jeagan626/J-Box/Jbox M3.jpeg

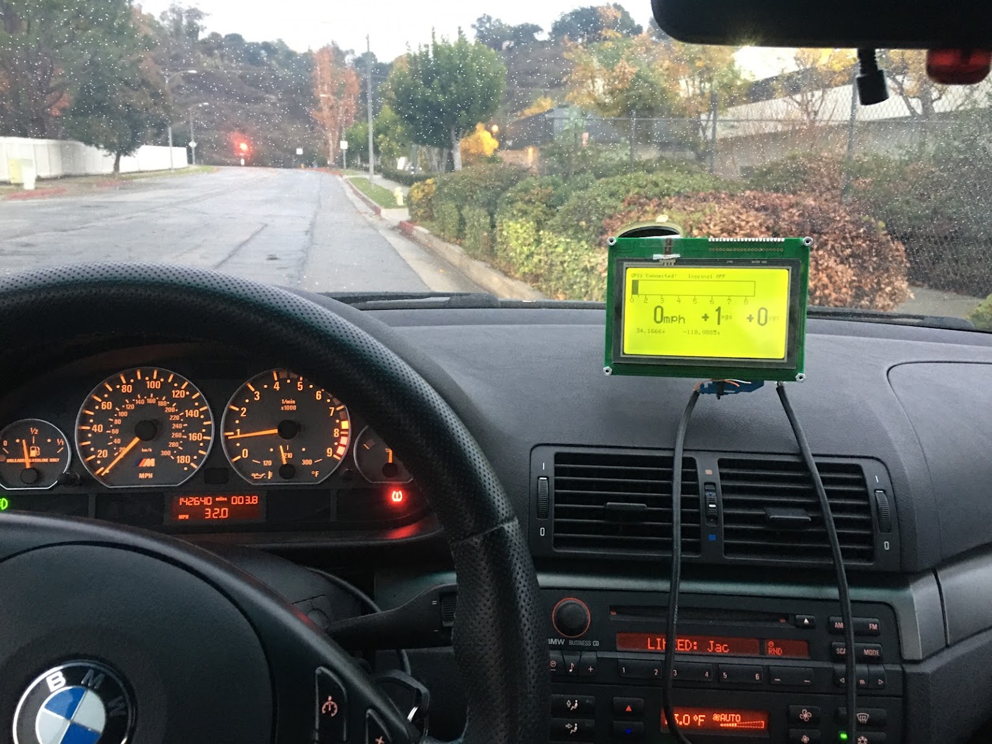
Jbox M3.jpeg
