jeagan626/J-Box/Imported Performance Logger.PrjPcb/BiggDisplay.STEP

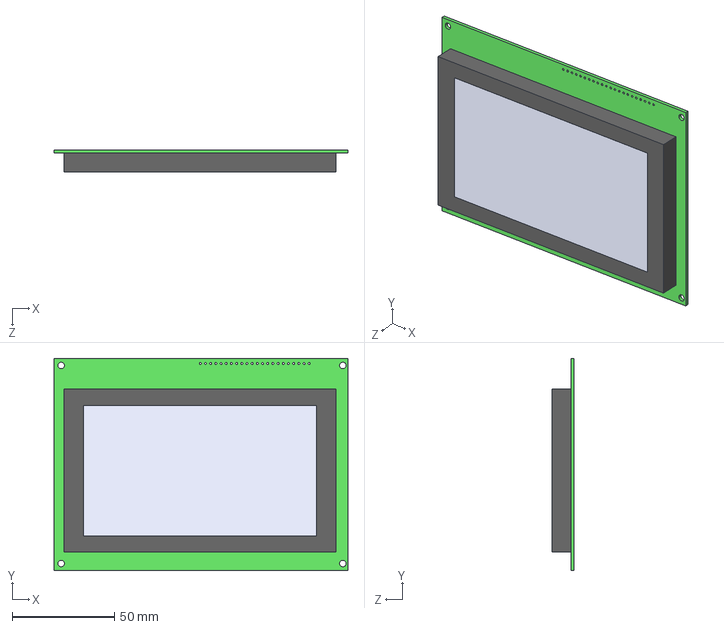
[picture p2: CAD file, 2021-08-30]
Imported Performance Logger.PrjPcb/BiggDisplay.STEP
144.0 x 104.0 x 11.0 mm
