jeagan626/J-Box/(list of files, cad)

Other CAD files:
Imported Performance Logger.PrjPcb/BiggDisplay.SLDPRT
