jeagan626/J-Box/(list of files, drawings)

Other design files:
Imported Performance Logger.PrjPcb/New folder/Performance Logger1.PcbLib
Imported Performance Logger.PrjPcb/New folder/Performance Logger.PcbDoc
Imported Performance Logger.PrjPcb/New folder/Performance Logger.PrjPcb
Imported Performance Logger.PrjPcb/New folder/Performance Logger.SchDoc
