jeagan626/J-Box/(commit log)

2021-08-15 Broke Up into multiple files
    [gps.cpp, main.cpp]
2021-08-30 Added Electronics Documents
    [BiggDisplay.SLDPRT, BiggDisplay.STEP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]
2021-12-15 added digital gauge class
    Started IO integration, added class for printing digital values to the screen
2021-12-20 Performance Improvements
    To do: write function that correctly rotates the update coordinates
    [display.cpp]
2021-12-23 minor improvements
    cut 5ms off display time by eliminating redundant updates
2021-12-24 Switched to interrupt based timing for RPM counting
2021-12-25 minor performance improvement and patches
    Staged display requests to avoid writing to the display unless new information is present. Fixed digital gauge issues with integers.
    [display.cpp, main.cpp]
2021-12-26 Started Logging integration
    Added basic functions to support logging. Ability to easily display dates with the LCD. SD initialization function. Also method to sync Teensy RTC with GPS clock for better time stability.
    Firmware info:
    RAM: [= ] 5.2% (used 13548 bytes from 262136 bytes)
    Flash: [== ] 22.6% (used 118472 bytes from 524288 bytes)
    [display.cpp, display.h, gps.cpp, gps.h, logging.cpp, main.cpp]
2021-12-26 Minor improvement
    Switched to constant for storage of icon bits. Removed extra junk from sd initialization process
    RAM: [ ] 4.7% (used 12252 bytes from 262136 bytes)
    Flash: [== ] 22.6% (used 118376 bytes from 524288 bytes)
2021-12-28 Major Update
    -added button and touch event classes for creation of GUI
    -added to logging (successfully creates a CSV file)
    - added to time stamping functions
    -added global data (to pass variables between files)
2021-12-28 Basic Logging
    Log button now starts a new log and stops a log. Pretty simple- button and touch handling could use some improvement, as some spots are "bouncy"
2021-12-28 fixed display glitch
    tachometer needs to be written before status. perhaps tach overwrites too much data
    [display.cpp]
2021-12-28 Minor bug fix
    The allocated length of dateTimeString was too small causing the date display on the screen to freeze.
    [logging.cpp]
2021-12-28 logging addendum
    added more digits to in lat and lon in logs,
    Added ability to start logging to SD
    inserted while running without a restart
    BUGS:
    The file directory is messy
    [display.cpp, logging.cpp]
2021-12-28 Logging Update
    Major improvements in logging reliability.
    - Has enum to track any sd /logging related errors.
    -displays any errors related to logging
    -is able to successfully initialize a log with the sd hotswapped
    -automatically places logs in a dated directory and names them according to the time
    RAM: [ ] 4.8% (used 12460 bytes from 262136 bytes)
    Flash: [== ] 23.5% (used 123168 bytes from 524288 bytes)
    [display.cpp, globalData.cpp, globalData.h, logging.cpp]
2022-01-02 Update J-Box Schematic.pdf
    Changed Schematic to reflect pinout used on connector old pin numbers are on outside and new pin numbers are on inside. Pinout expected to be changed in the future so that pin 1 is pin one. But for now this takes some of the guess work out of wiring the J-Box
2022-01-04 Gui expansion + insight screen
    Functioning menu screen as well as "insight" and "M3" screens, FSAE sample screen is accessible from menu as well, but there is no way to exit the screen as of now
    Early stages of functionality for Honda insight application, within the IO file, which handles the reading of sensors and serial data.
    RAM: [= ] 5.1% (used 13352 bytes from 262136 bytes)
    Flash: [=== ] 32.8% (used 172096 bytes from 524288 bytes)
2022-01-04 Restored Tachometer
    Fixed a bug where the tachometer would not detect pulses. It seems the interrupt did not have a high enough priority because it was attached earlier.
    [main.cpp]
2022-01-04 Basic code for new method of reading the tach
    find the intervals between the pulses and invert them to get frequency
    [display.cpp, main.cpp]
2022-01-04 Tachometer Update
    Tachometer now reads with 1hz resolution in nearly every case. it updates quickly because it measures the time between pulses and calculates frequency based on an average of periods. May be time intensive though, but initial tests are good.
    RAM: [= ] 5.1% (used 13400 bytes from 262136 bytes)
    Flash: [=== ] 32.9% (used 172288 bytes from 524288 bytes)
2022-01-04 minor tach updates
    removed extraneous debugging messages. Increased tolerance of tach frequency.
    [io.cpp]
2022-01-04 Fixed tachometer for M3
    RPM per Pulse was 20 not 25
    [display.cpp, globalData.cpp, globalData.h, io.cpp]
2022-01-08 insight patches
    Added support for newer obdII c&c firmware, the device has a higher bitrate and the messages are inverted
    [io.cpp]
2022-01-08 minor improvements
    - Added support for teensy 3.6 (not yet tested)
    - increased length of c strings as a precaution against possible cases of buffer overflow
    - changed the way logs are written to make it easier to keep track of parameters that are written
    - renamed engineLoad variable to engLoad be consistent with other variable names
    Advanced Memory Usage is available via "PlatformIO Home > Project Inspect"
    RAM: [= ] 5.1% (used 13496 bytes from 262136 bytes)
    Flash: [=== ] 28.7% (used 150520 bytes from 524288 bytes)
2022-01-18 Added Insight Parameters and speed improvements
    JBox now runs on Teensy 3.6 and is faster. There are still some performance bottle necks being patched. Current focus is on use as a gauge and logger. Latest OBDII C&C serial support has been added.
2022-01-19 Added additional Insight Parameters
    -Additional insight parameters
    -Loop and item times are now being logged as well.
    - added experimental millisecond method (should work for teensy 4.1) But not yet working
    - Teensy 3 rtc milliseconds doesn't seem to roll over the same time as seconds (find some fix) this is annoying as it messes up the time difference calculations in the csv log file.
    [display.cpp, globalData.cpp, globalData.h, io.cpp, logging.cpp, main.cpp]
2022-01-20 Fixed Millisecond Counter
    Timer now should work with teensy 4.1, does not produce funky logs
    [globalData.h, gps.cpp, logging.cpp, main.cpp]
2022-01-20 Insight Updates
    Note there has been some issues withthe gauge crashing
    [display.cpp, globalData.cpp, globalData.h, io.cpp, logging.cpp]
2022-01-24 Added additional Gauges fixed crashing issue
    Crash issue was due to a buffer overload from sprintf
    changed tach pin to pin 11 on jbox
    added turbine pressure and fuel pressure
    [display.cpp, globalData.cpp, globalData.h, io.cpp, logging.cpp]
2022-01-24 Added "Dumb Boost Control"
    Super simple boost control. Doesn't work that well, but is in improvement over the wastegate on the turbo insight
    [io.cpp, main.cpp]
2023-11-17 Added Tach file
    Added brightness adjustment settings
    [Performance Logger.PcbDoc, Performance Logger.PrjPcb, Performance Logger.SchDoc, Performance Logger1.PcbLib]
